lodjim/fonek/fonek/design/netlist.csv

net | reference | physical_pad
GND | J1 | A12
GND | J1 | B12
GND | J1 | S1
GND | D3 | 2
GND | R1 | 2
GND | R2 | 2
GND | U2 | 5
GND | C1 | 2
GND | C2 | 2
GND | R3 | 2
GND | BAT1 | -
GND | Q1 | 2
GND | R6 | 2
GND | U3 | 2
GND | C3 | 2
GND | C4 | 2
GND | C5 | 2
GND | U1 | 1
GND | U1 | 15
GND | U1 | 38
GND | U1 | 39
GND | C6 | 2
GND | D1 | K
GND | R11 | 2
GND | TP2 | 1
VBUS_RAW | J1 | A9
VBUS_RAW | J1 | B9
VBUS_RAW | F1 | 1
VBUS_RAW | D3 | 1
VBUS | F1 | 2
VBUS | U2 | 6
VBUS | C1 | 1
VBUS | R4 | 1
VBUS | R5 | 1
VBUS | TP8 | 1
CC1 | J1 | A5
CC1 | R1 | 1
CC2 | J1 | B5
CC2 | R2 | 1
ISET | U2 | 4
ISET | R3 | 1
CHG_LED_A | R4 | 2
CHG_LED_A | D2 | A
CHG | D2 | K
CHG | U2 | 3
NTC | BAT1 | T
NTC | U2 | 1
NTC | R11 | 1
VBAT | U2 | 2
VBAT | C2 | 1
VBAT | BAT1 | +
VBAT | SW1 | 1
VBAT | TP7 | 1
SYS_BAT | SW1 | 2
SYS_BAT | U3 | 1
SYS_BAT | C3 | 1
SYS_BAT | R7 | 1
Q_GATE | R5 | 2
Q_GATE | R6 | 1
Q_GATE | Q1 | 1
LDO_EN | R7 | 2
LDO_EN | Q1 | 3
LDO_EN | U3 | 3
3V3 | U3 | 5
3V3 | C4 | 1
3V3 | C5 | 1
3V3 | U1 | 2
3V3 | R8 | 1
3V3 | R9 | 1
3V3 | R10 | 1
3V3 | TP1 | 1
ESP_EN | U1 | 3
ESP_EN | R8 | 2
ESP_EN | C6 | 1
ESP_EN | TP5 | 1
BOOT | U1 | 25
BOOT | R9 | 2
BOOT | TP6 | 1
PWR_LED_A | R10 | 2
PWR_LED_A | D1 | A
UART_TX | U1 | 35
UART_TX | TP3 | 1
UART_RX | U1 | 34
UART_RX | TP4 | 1
