lodjim/fonek/fonek/pcbway/FABRICATION_MANIFEST.txt

fonek rev A bare PCB fabrication files
SHA256  filename
fe00023e081707c45bcdf6ad558f19f4de7d6589786049c677f1d1a6a260e4d0  fonek-B_Cu.gbl
26f7c3ea669f30dafd4bdc09c5a59b2c9827bd8fbe4e381205ae9ca718b39c1d  fonek-B_Mask.gbs
7433796640a39dfc1d747abaf10675e29df039c1384ed8e26e95ffd9569596da  fonek-B_Silkscreen.gbo
70a0d5adfc1642e141cab41b52a42c268dec3e6aac34e4b81b050bd0d4d7b11b  fonek-Edge_Cuts.gm1
62e4e9ef9db9a180ec5dc0de824673770b1e0dbc6a9e5d9e4cb61d0422693239  fonek-F_Cu.gtl
c7a2463f52afe66c29edd4e68a7a474c07811d1770361772912d4bf1ae69ca5c  fonek-F_Mask.gts
e723c8cffa965613d530e815994ff890bdb4f259b57fba6d8bf29556eba96259  fonek-F_Silkscreen.gto
88b8b45ca98976f54ef41422c22b1fafda9742efc287110c6d7b08793da85eba  fonek-NPTH.drl
d74f35e0eed280f8e075c822b14881555b7546ed34494b961701da290ed1520f  fonek-PTH.drl
