lodjim/fonek/(list of files, drawings)

Other design files:
fonek/routing/fonek.dsn
