lodjim/fonek/fonek/kicad/fonek.kicad_pcb

## KiCad design fonek/kicad/fonek.kicad_pcb (2026-10-06)

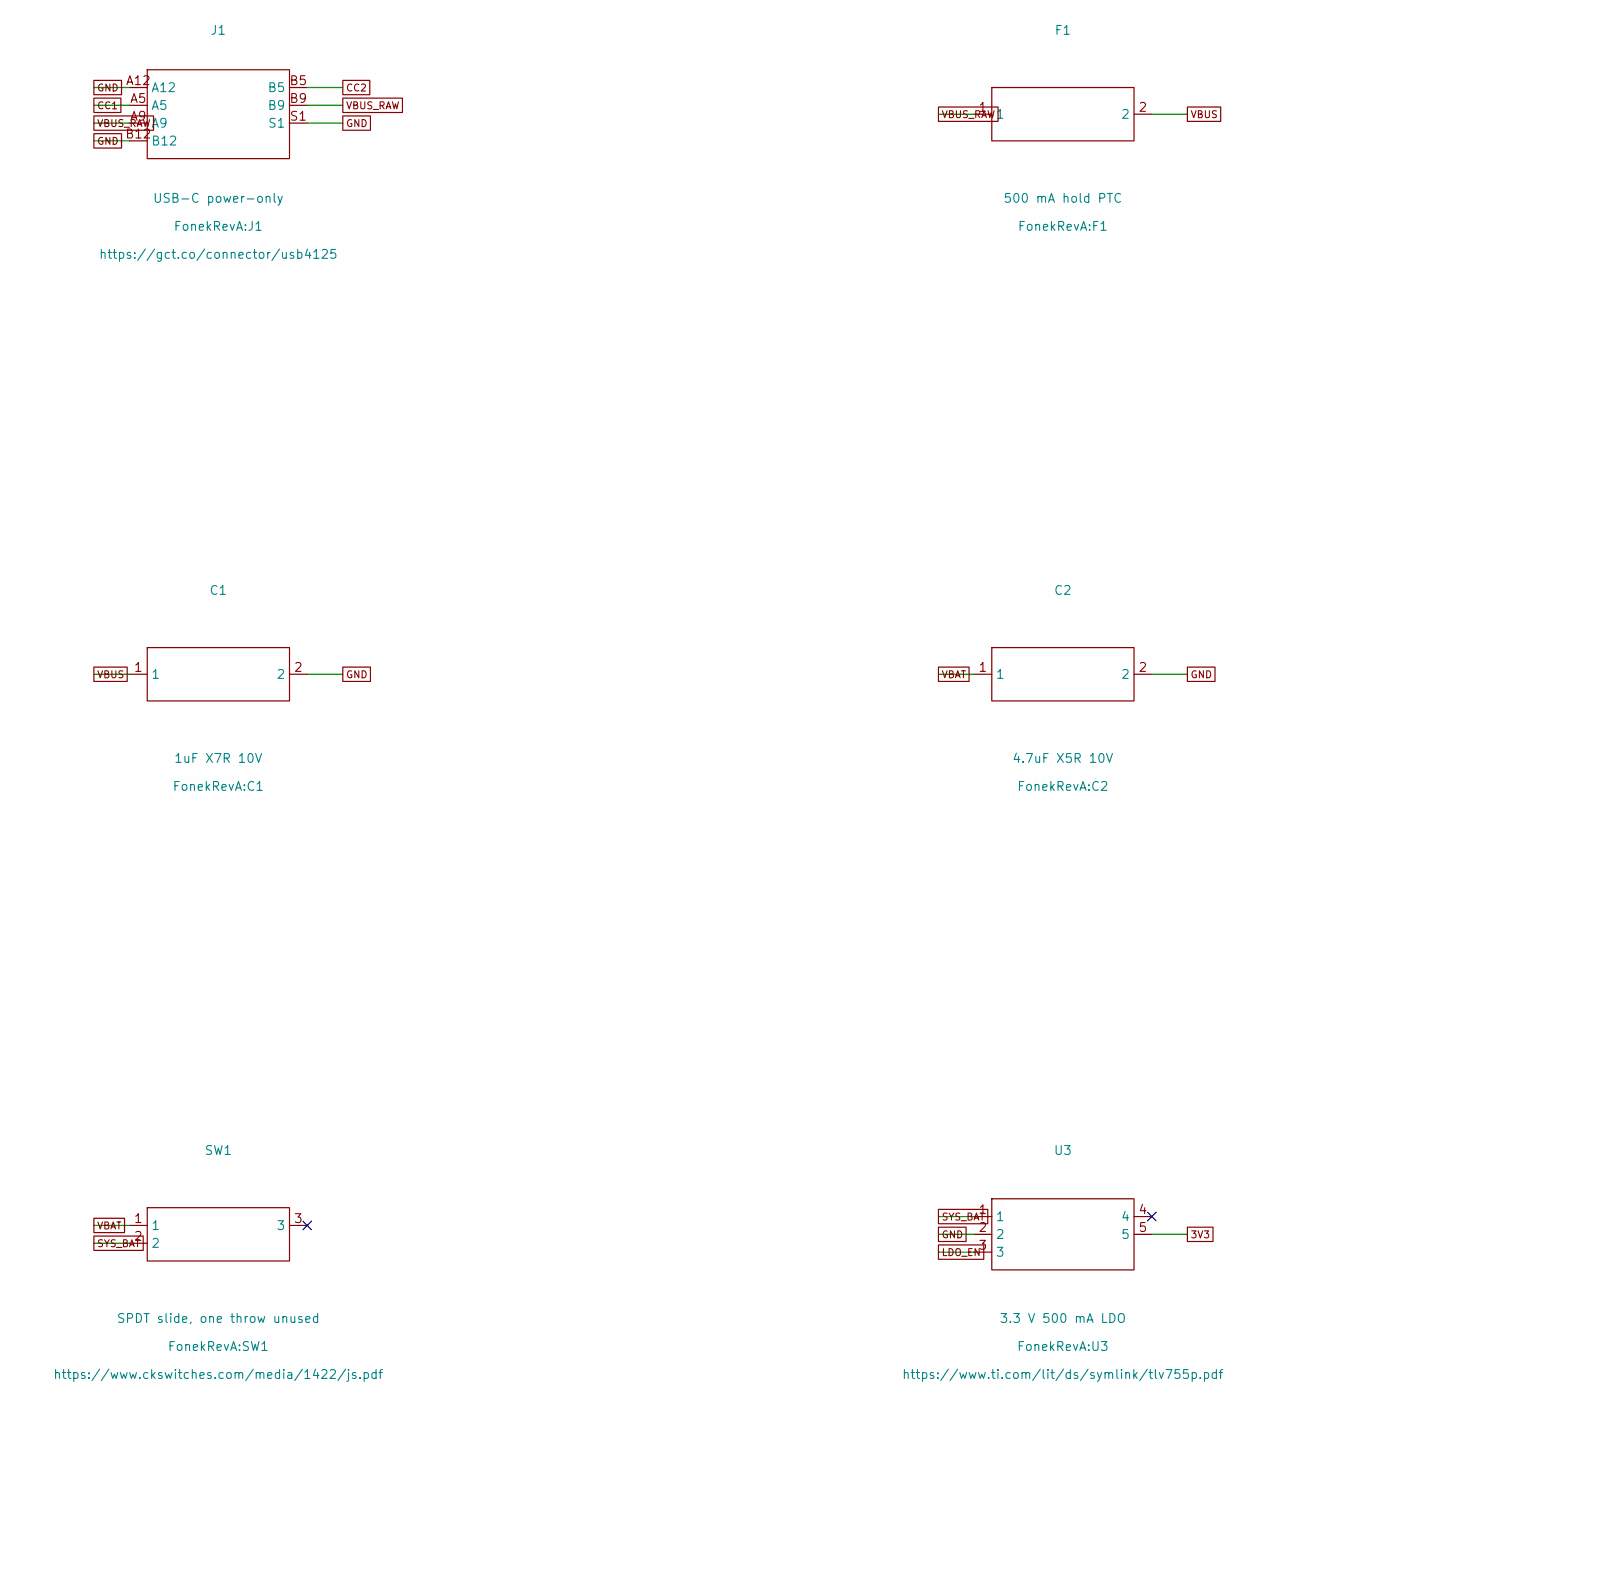
[picture p2: schematic fonek.kicad_sch, part in row 1, column 1]

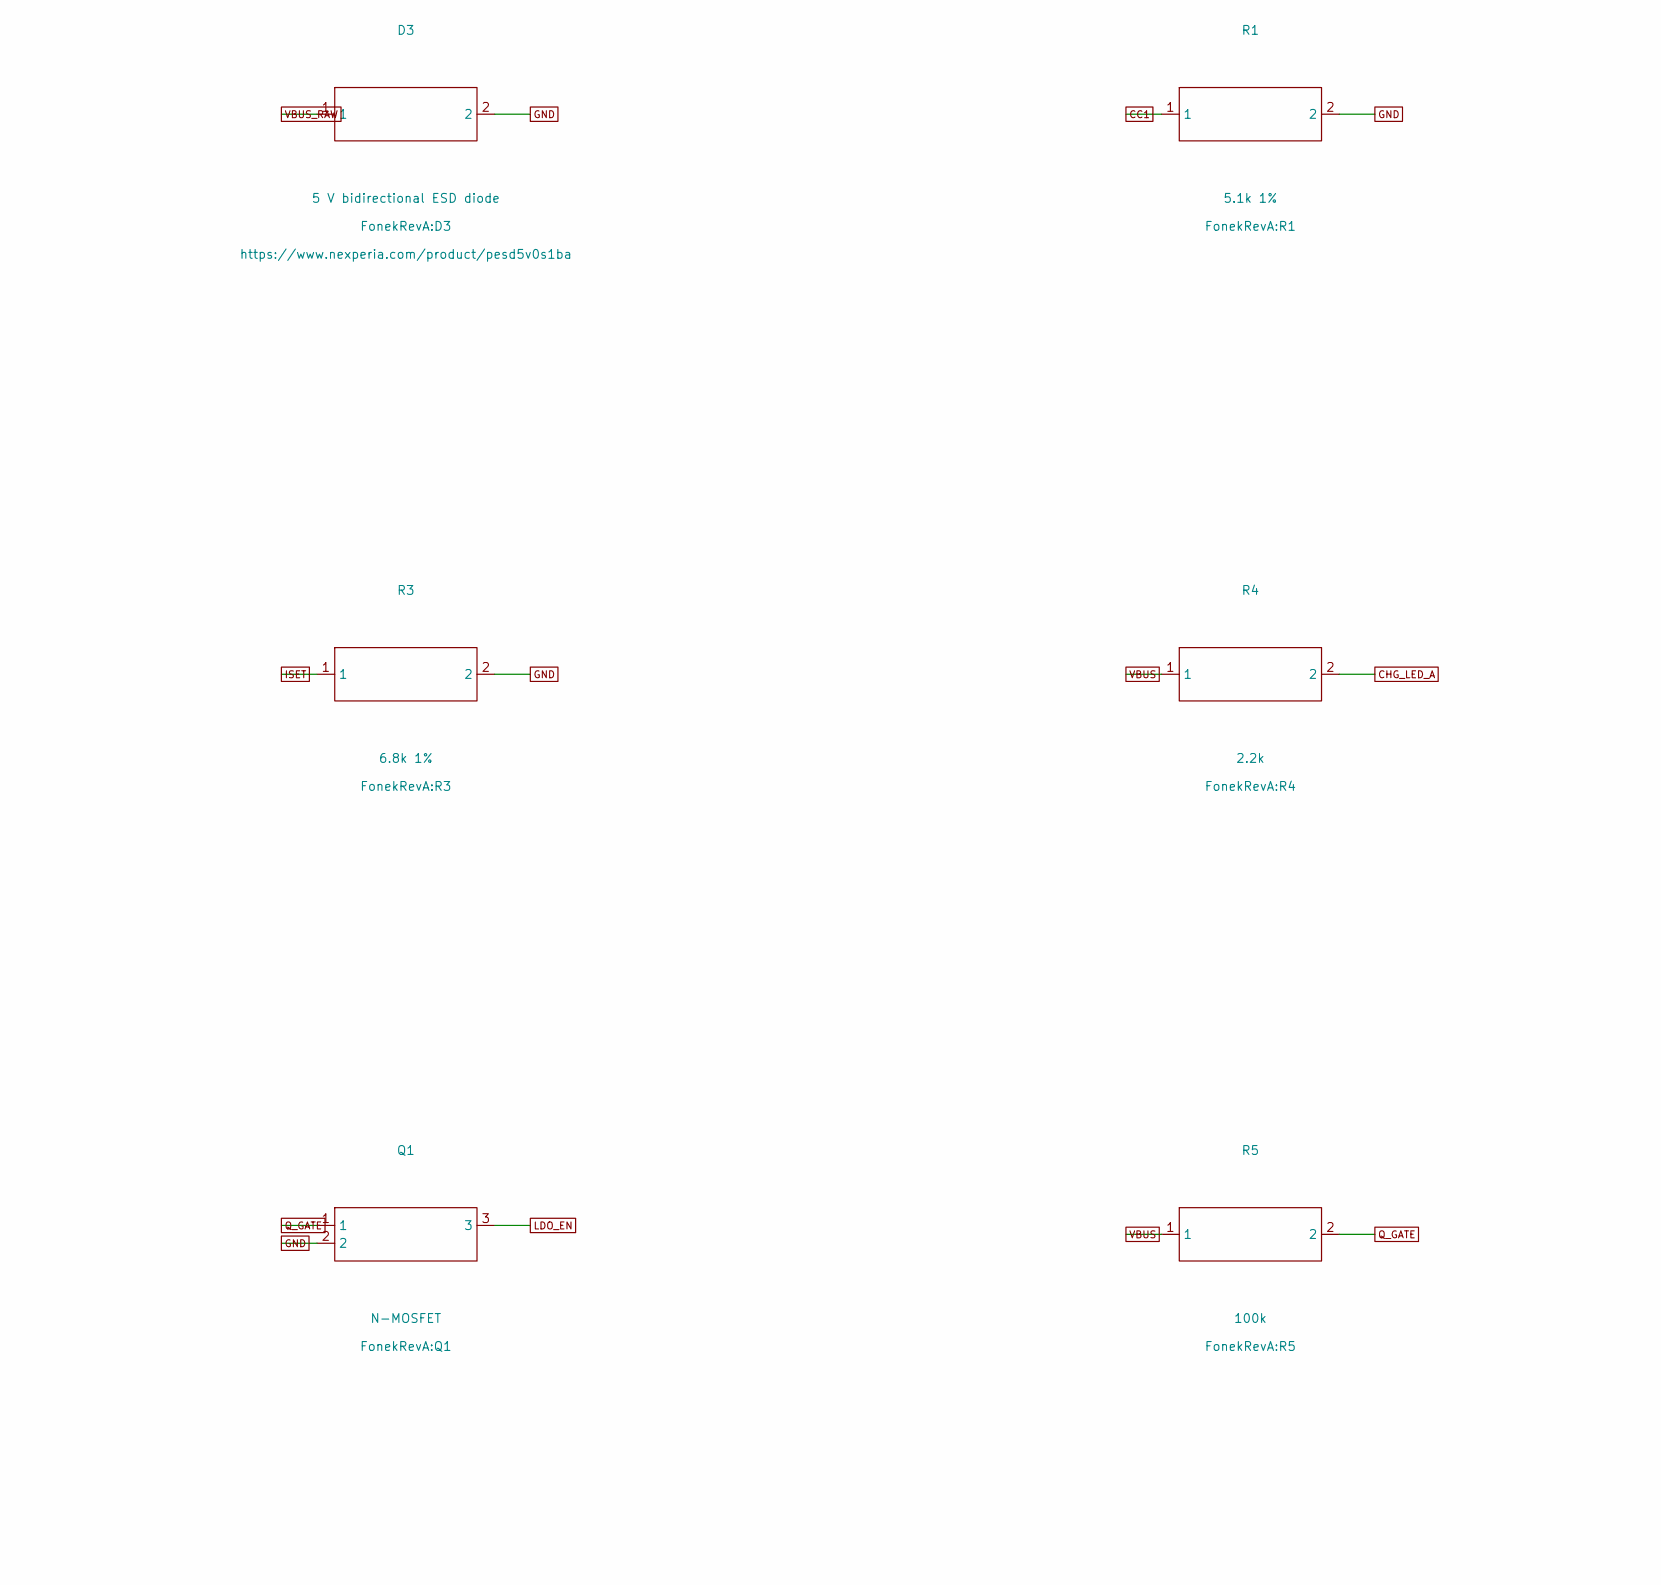
[picture p3: schematic fonek.kicad_sch, part in row 1, column 2]

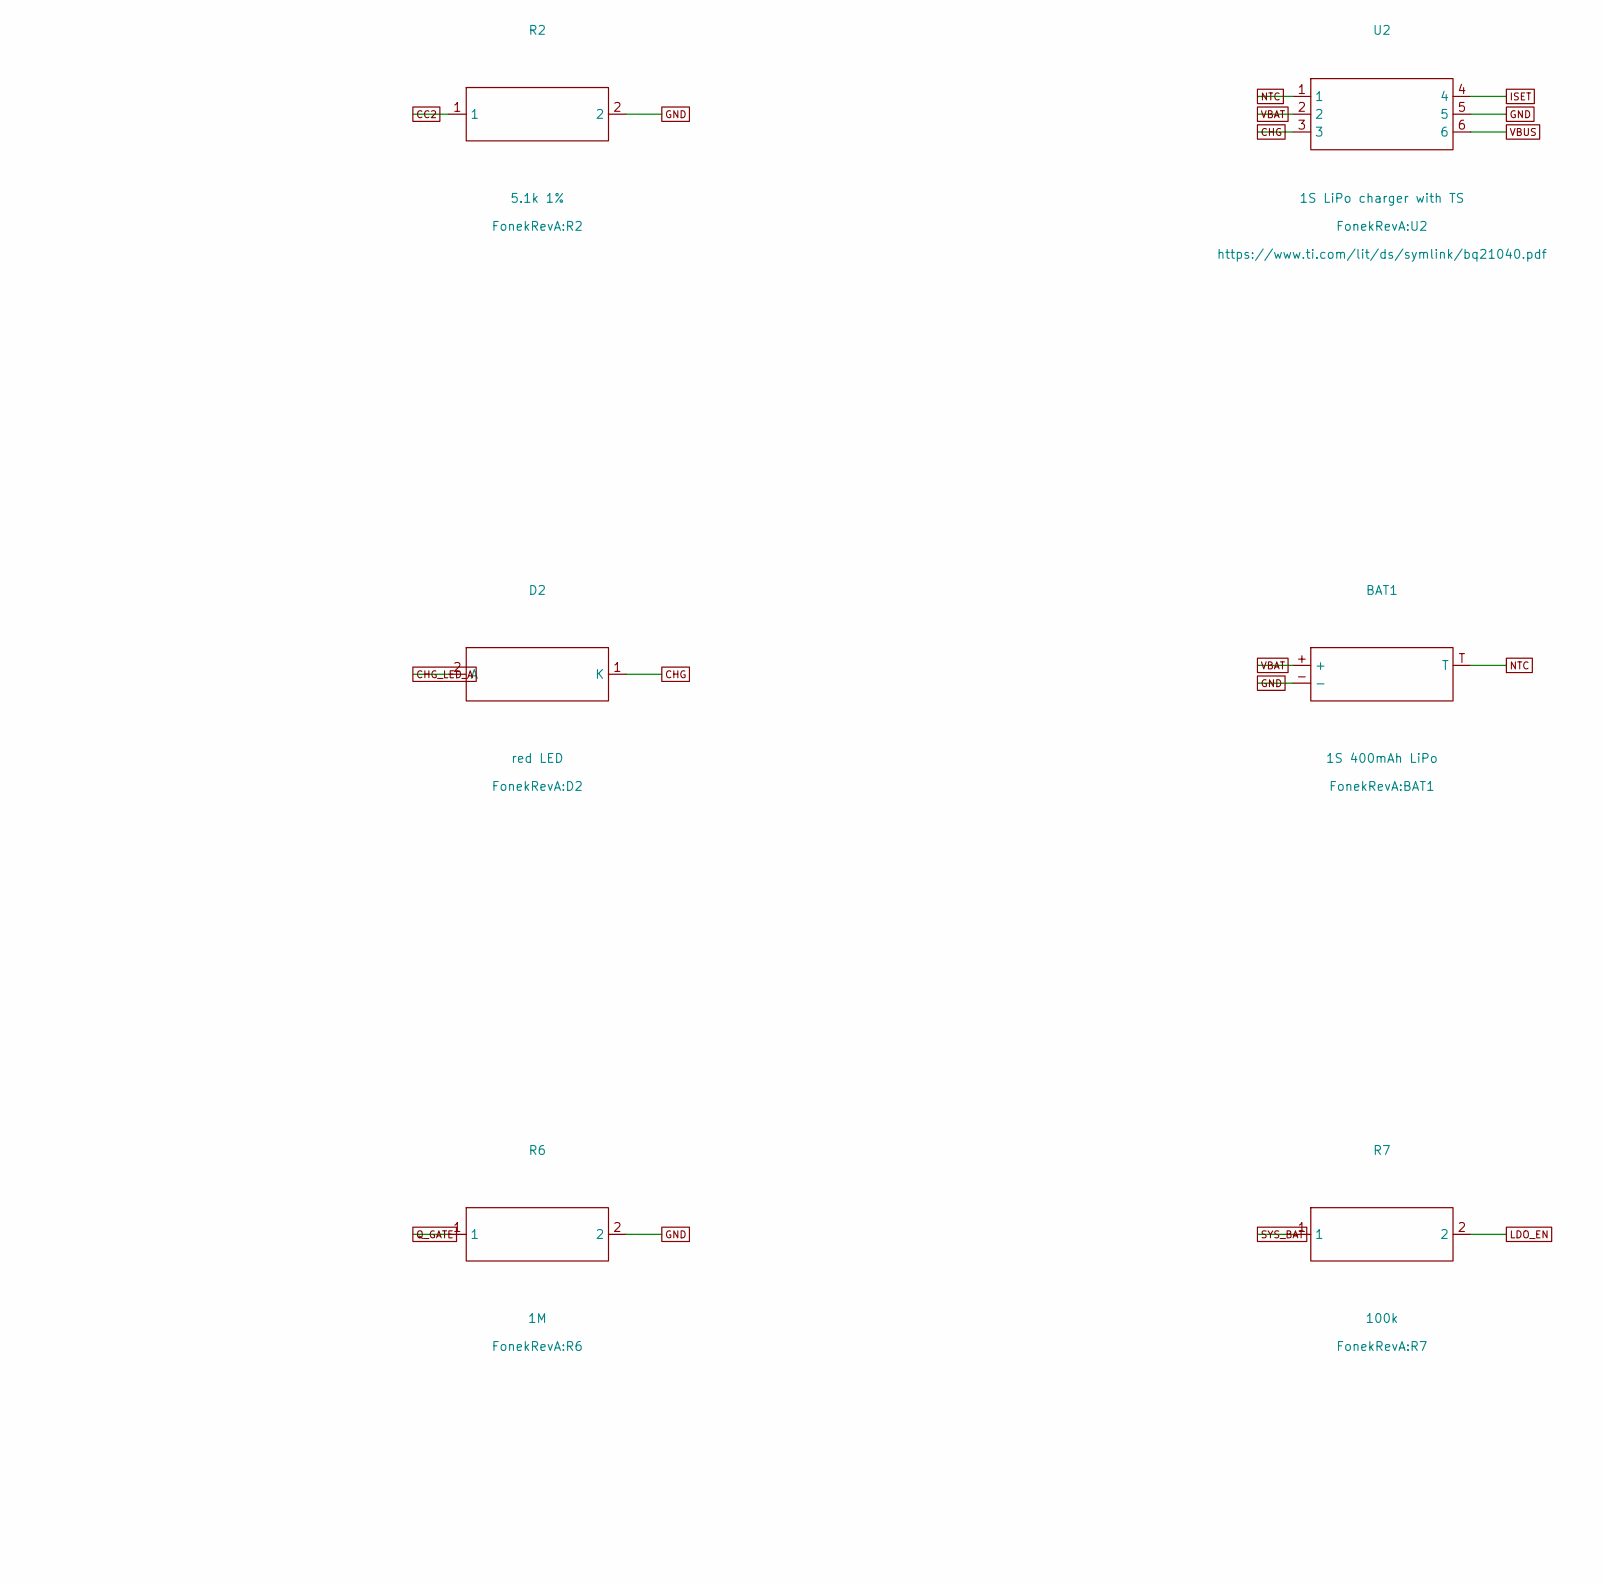
[picture p4: schematic fonek.kicad_sch, part in row 1, column 3]

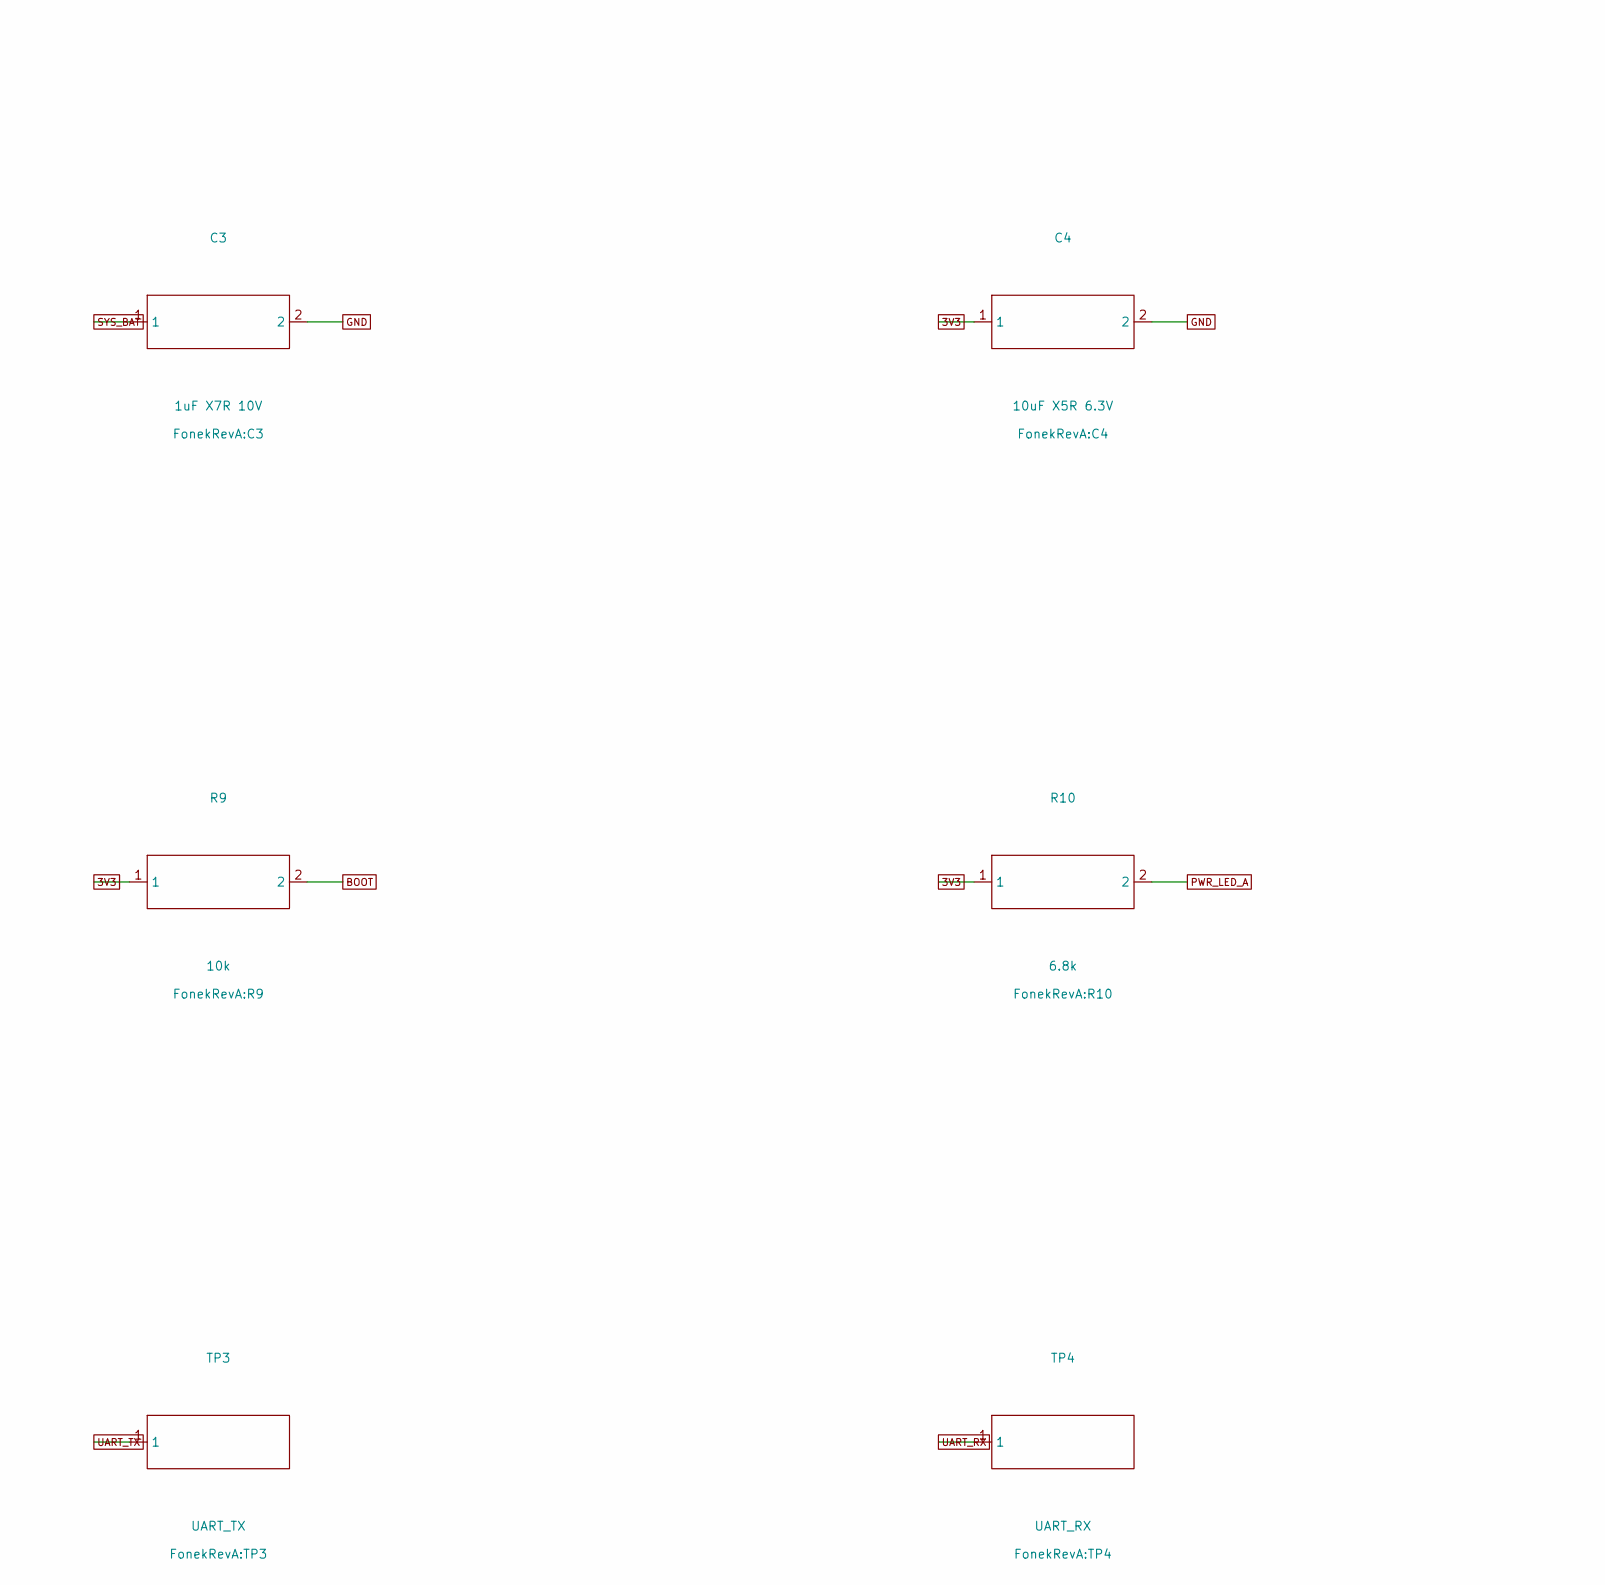
[picture p5: schematic fonek.kicad_sch, part in row 2, column 1]

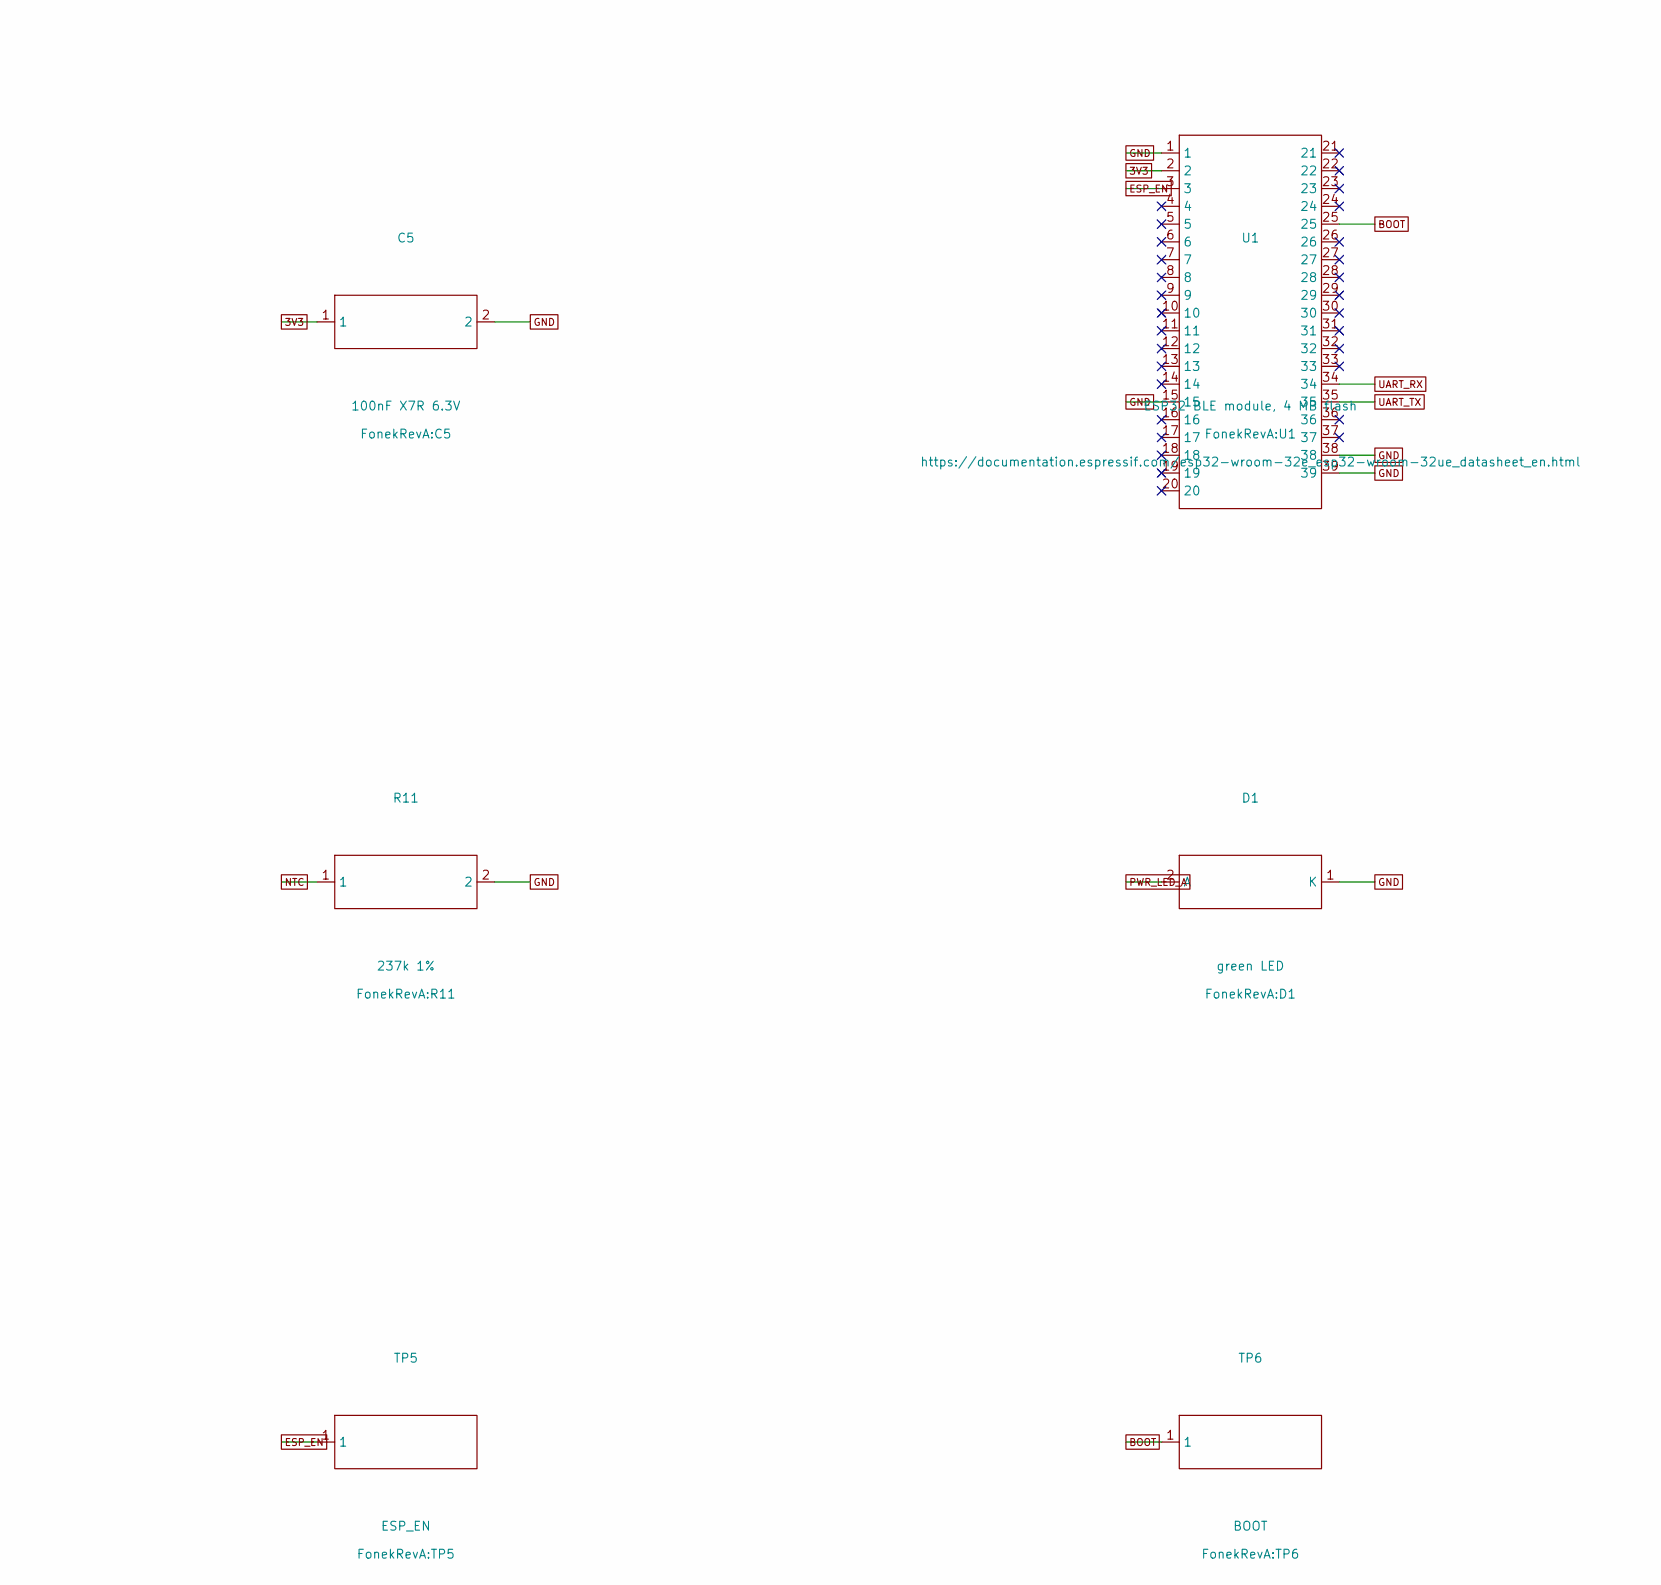
[picture p6: schematic fonek.kicad_sch, part in row 2, column 2]

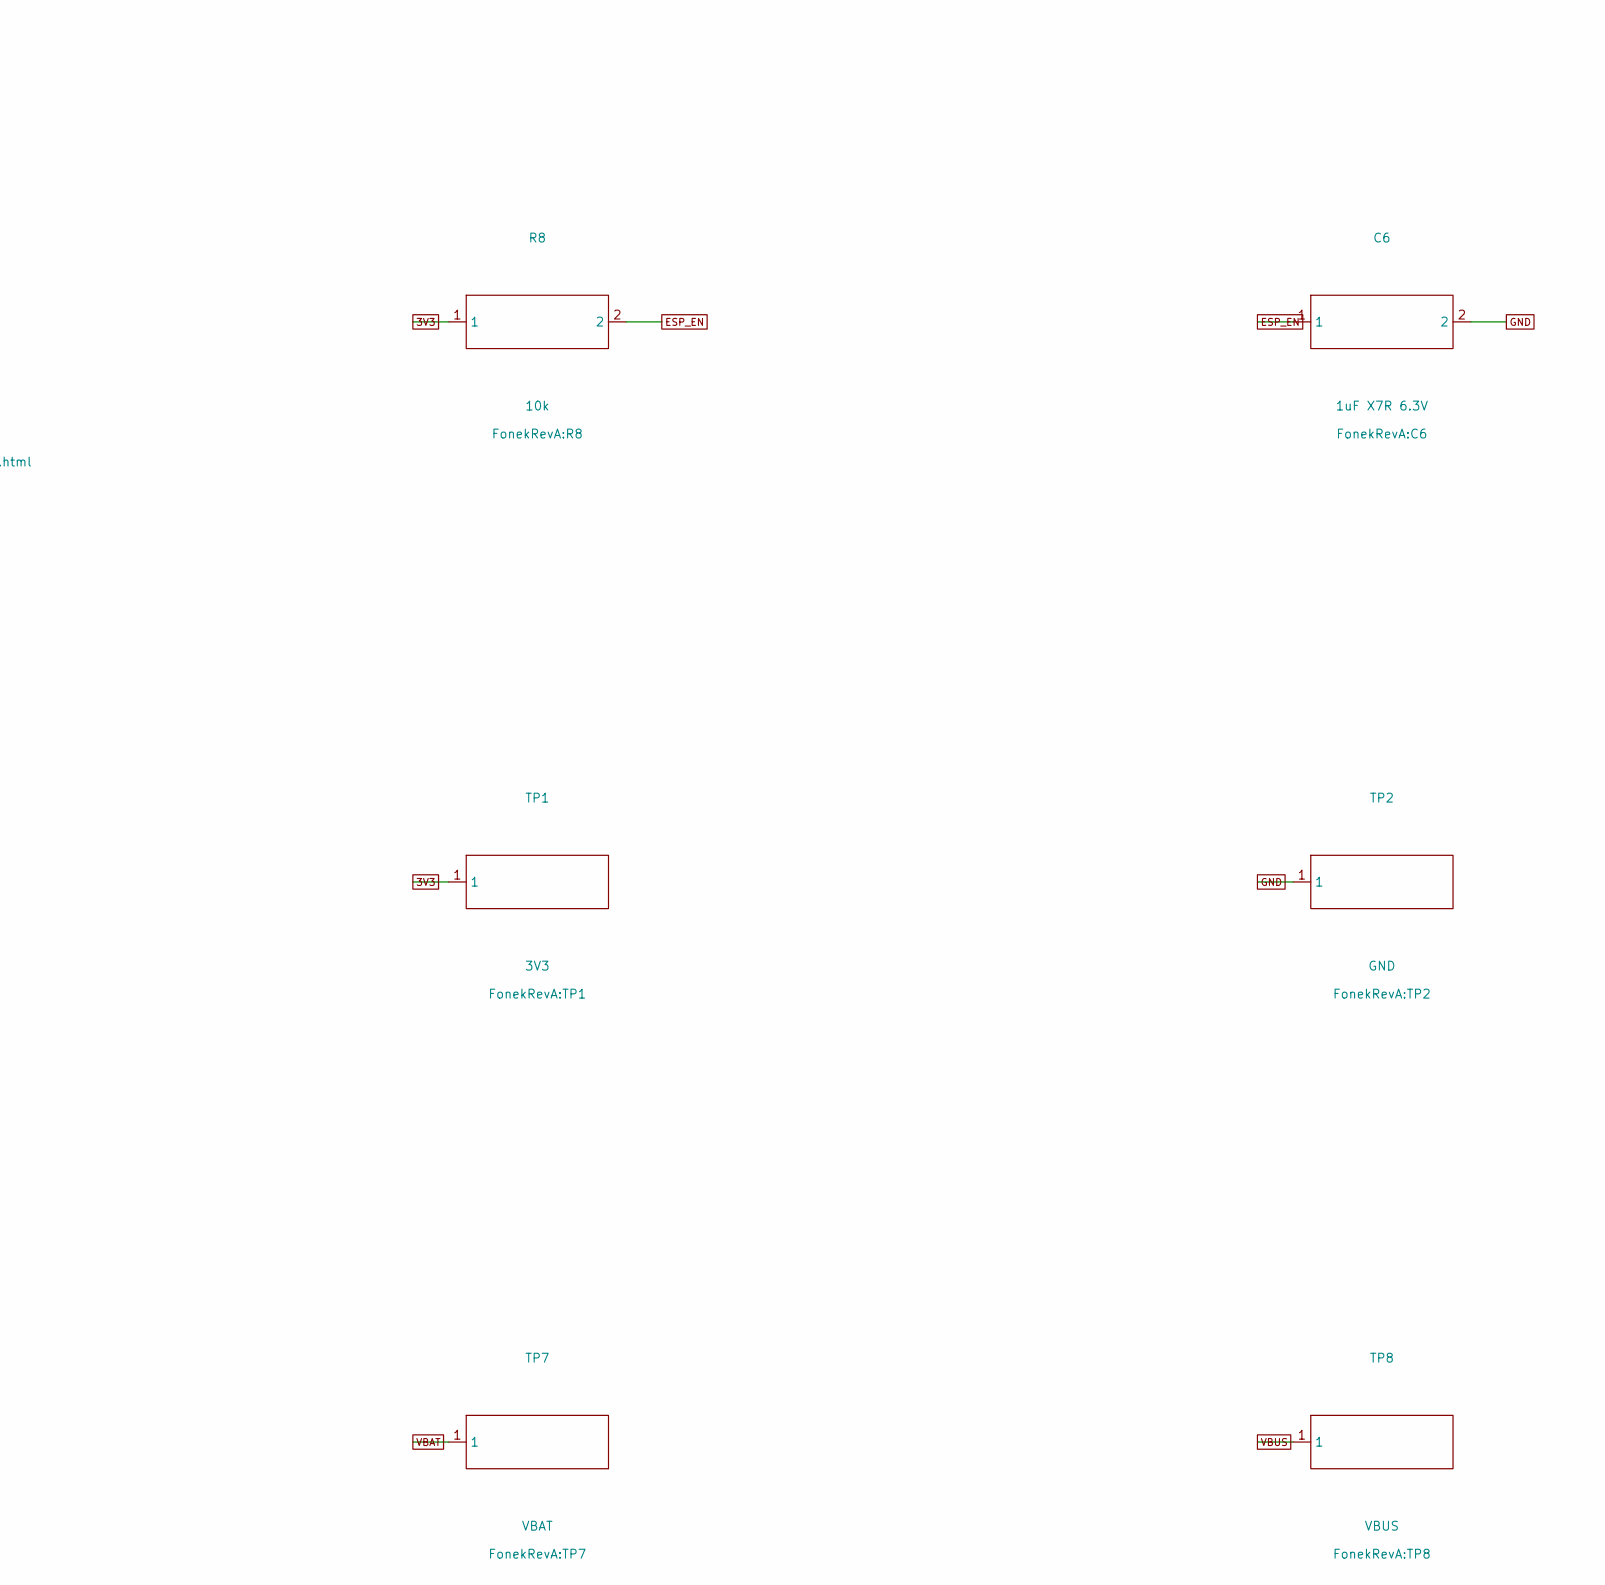
[picture p7: schematic fonek.kicad_sch, part in row 2, column 3]

Parts:
BAT1: 1S 400mAh LiPo; BAT1
C1: 1uF X7R 10V; C1
C2: 4.7uF X5R 10V; C2
C3: 1uF X7R 10V; C3
C4: 10uF X5R 6.3V; C4
C5: 100nF X7R 6.3V; C5
C6: 1uF X7R 6.3V; C6
D1: green LED; D1
D2: red LED; D2
D3: 5 V bidirectional ESD diode; D3
F1: 500 mA hold PTC; F1
J1: USB-C power-only; J1
Q1: N-MOSFET; Q1
R1: 5.1k 1%; R1
R2: 5.1k 1%; R2
R3: 6.8k 1%; R3
R4: 2.2k; R4
R5: 100k; R5
R6: 1M; R6
R7: 100k; R7
R8: 10k; R8
R9: 10k; R9
R10: 6.8k; R10
R11: 237k 1%; R11
SW1: SPDT slide, one throw unused; SW1
TP1: 3V3; TP1
TP2: GND; TP2
TP3: UART_TX; TP3
TP4: UART_RX; TP4
TP5: ESP_EN; TP5
TP6: BOOT; TP6
TP7: VBAT; TP7
TP8: VBUS; TP8
U1: ESP32 BLE module, 4 MB flash; U1
U2: 1S LiPo charger with TS; U2
U3: 3.3 V 500 mA LDO; U3

Connections:
3V3: C4.1, C5.1, R8.1, R9.1, R10.1, TP1.1, U1.2, U3.5
BOOT: R9.2, TP6.1, U1.25
CC1: J1.A5, R1.1
CC2: J1.B5, R2.1
CHG: D2.1 (K), U2.3
CHG_LED_A: D2.2 (A), R4.2
ESP_EN: C6.1, R8.2, TP5.1, U1.3
GND: BAT1.-, C1.2, C2.2, C3.2, C4.2, C5.2, C6.2, D1.1 (K), D3.2, J1.A12, J1.B12, J1.S1, Q1.2, R1.2, R2.2, R3.2, R6.2, R11.2, TP2.1, U1.1, U1.15, U1.38, U1.39, U2.5, U3.2
ISET: R3.1, U2.4
LDO_EN: Q1.3, R7.2, U3.3
NTC: BAT1.T, R11.1, U2.1
PWR_LED_A: D1.2 (A), R10.2
Q_GATE: Q1.1, R5.2, R6.1
SYS_BAT: C3.1, R7.1, SW1.2, U3.1
UART_RX: TP4.1, U1.34
UART_TX: TP3.1, U1.35
VBAT: BAT1.+, C2.1, SW1.1, TP7.1, U2.2
VBUS: C1.1, F1.2, R4.1, R5.1, TP8.1, U2.6
VBUS_RAW: D3.1, F1.1, J1.A9, J1.B9

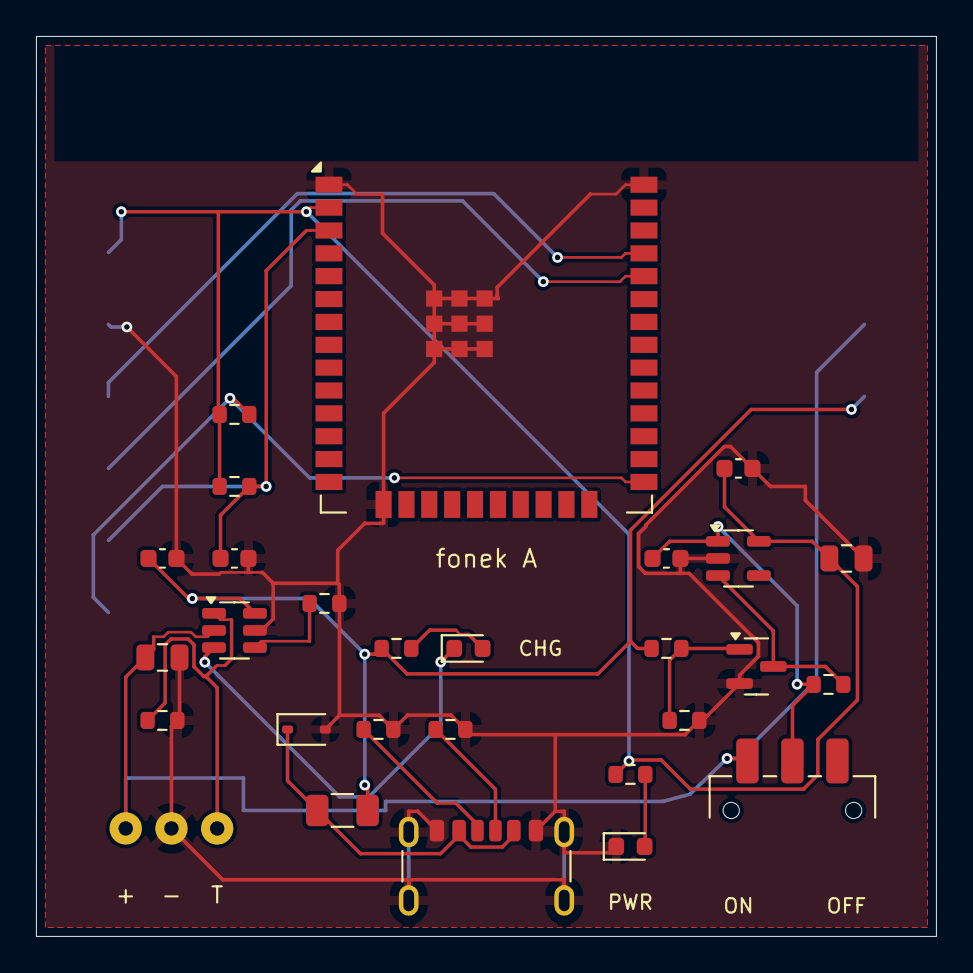
[picture p8: board fonek.kicad_pcb from above]

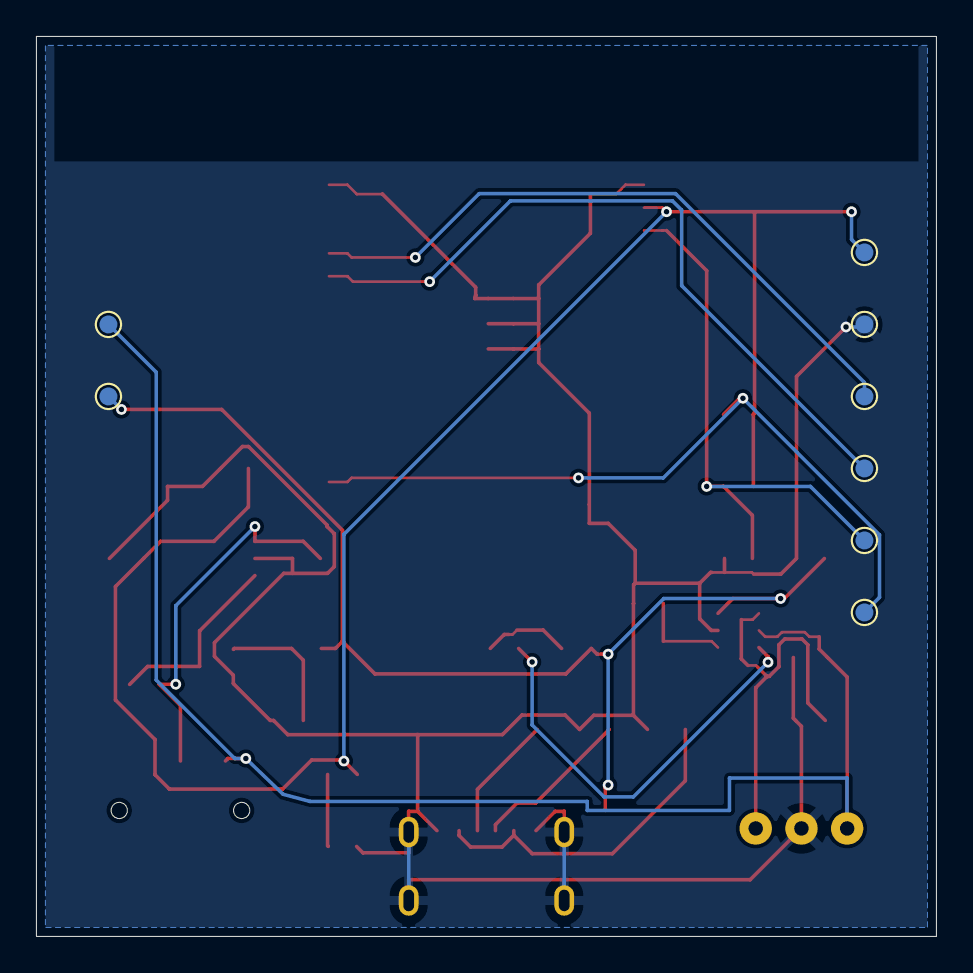
[picture p9: board fonek.kicad_pcb from below]

Board: 2 copper layers, 50.0 x 50.0 mm, 36 parts (8 on the bottom side), 19 nets.
